ruslan-hut/humi/(commit log)

2026-09-20 Initial commit: Go service, Angular dashboard, hardware plan
    Backend, phases 1 and 3 of IMPLEMENTATION.md:
    - chi + SQLite (modernc, CGO-free) with migrations embedded in the binary
    - POST /readings behind a per-node bearer token; takes a single reading or
    a batch with age_s, so a node that buffered while offline flushes in one wake
    - GET /nodes with computed online state; GET /nodes/{slug}/series with
    server-side bucket widening capped at 480 points
    - nodectl registers a node and prints its ingest token once
    Frontend:
    - Angular 22, standalone, signals, OnPush, no chart dependency
    - mobile-first dashboard; detail view with min/max band charts over
    24h/7d/30d, crosshair tooltips, table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
2026-09-27 Add bench firmware and board self-test (phase 2)
    - firmware/selftest: chip info, WiFi scan, I2C scan, live SHT4x reading
    - firmware/node: bench build — SHT4x read, WiFi, POST to /readings,
    interval_s taken from the reply; no deep sleep yet
    - secrets.h is gitignored; secrets.example.h documents the fields
    - firmware/README: arduino-cli build/flash steps, header soldering note
    (keep heat away from the USB-C connector), sensor gate moved D1 -> D3
    - ignore bin/
2026-09-27 Node firmware 0.2.2: deep sleep, sensor power gating, DHCP lease reuse
    - wake, measure, POST, deep sleep; server-owned interval_s kept in RTC memory
    - sensor module powered from D3 only while measuring (its LED, LDO and
    pull-ups are off in sleep); bus released before power-off
    - RTC ring buffer of 8 unsent readings, flushed as a batch with age_s
    - reconnect to the cached BSSID/channel and reuse the DHCP lease for up to
    6 h: awake time 3.7 s -> 0.23-0.47 s typical, measured on the bench
    - log buffered and printed before sleep, only waiting for a USB host
    - battery divider behind HAS_VBAT_DIVIDER, off until it is fitted
2026-09-27 Ignore arduino-cli build output
2026-09-27 Node firmware 0.3.1: battery voltage, stay awake on USB
    - battery divider on D2 enabled; vbat sent with every reading
    - per-node VBAT_SCALE in secrets.h (bench node reads 2.1 % high)
    - with a USB host attached the node waits awake instead of deep-sleeping,
    so it can be flashed and its log read without the BOOT button
    - firmware/README: calibration procedure; the meter's ~1 MΩ input
    impedance makes it useless for checking the divider directly
2026-09-29 Deploy to humi.nomadus.net; node firmware 0.4.0: HTTPS
    Firmware verifies the server against all four Let's Encrypt roots (ISRG
    X1/X2 and the generation-Y YE/YR), so a chain change does not need a
    reflash. http:// URLs still work for a bench server on the LAN.
    make bundle builds linux amd64+arm64 binaries and the web UI into one
    tarball; deploy/install.sh installs or upgrades it under systemd without
    touching an existing config or database. nginx keeps the ingest endpoint
    open to node tokens and puts basic auth in front of everything else until
    phase 5.
2026-09-29 Phase 5: sign-in, roles, sensor and access settings
    Users are admin or viewer. Sessions are opaque tokens stored as SHA-256,
    sent as an HttpOnly SameSite=Strict cookie, 30 days sliding and revocable
    per device; state-changing requests also need X-Requested-With. The first
    admin comes from userctl -invite admin, everyone else from invite links.
    The last admin cannot be demoted or removed.
    Settings, mobile first (Angular Signal Forms):
    - Sensors: add (token shown once), rename, interval, on/off, per-node
    thresholds, rotate token, delete
    - People & access: roles, 7-day invite links, 24-hour reset links,
    revoking open links
    - Account: change password, signed-in devices
    Dashboard humidity b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
